omarheshamm0/vechile-dashboard-NTI/Vehicle_Dashboard_Report.docx

PRJ-04-DASHBOARD

Vehicle Instrument Cluster

Final Project Report · ATmega32A @ 8 MHz · SimulIDE

Field | Value
Project code | PRJ-04-DASHBOARD
Team | Omar Hesham Elsayed · Ahmed Khaled Mohamed · Omar Abdelaziz Elsaid Elaraby · Abdelrahman Hesham Abdullah
Team size | 4 students
Repository | https://github.com/omarheshamm0/vechile-dashboard-NTI.git
MCU / clock | ATmega32A @ 8 MHz, internal peripherals only
Simulator | SimulIDE 2.0.0-260501
Build window | Days 11 – 15 (Sep 13 – Sep 17, 2026)
Demo & submission | Sep 17, 2026
Dominant skill | Timer1 input capture · bidirectional shared SPI bus · atomic 32-bit counters

# Table of Contents

Ch. | Title
1 | Executive Summary
2 | System Description — inputs, outputs, hardware components
3 | Circuit — schematic and pin map as built
4 | Peripheral Configuration — tick and Timer1 derivations
5 | Software Architecture — layers, modules, concurrency contract
6 | Speed Measurement — method, the ICP1 fault, the INT2 workaround
7 | Timing Derivation — speed maths, resolution, RPM maths, ISR budget
8 | Odometer and Atomic 32-bit Access — tearing, persistence, write budget
9 | The Shared SPI Bus — arbitration rules and failure modes
10 | Warning Lamps and Priority
11 | Ignition State Machine — diagram, transitions, operating modes
12 | Analogue Gauges and Display
13 | Diagnostics Protocol — frame, commands, events
14 | Task Scheduling — table and worst-case tick
15 | Test Matrix — all 52 cases
16 | Non-Functional Compliance — NFR table and stack depth
17 | Limitations and Deviations
18 | Conclusion

# 1. Executive Summary

This project implements the instrument cluster of a car on an ATmega32A: the speedometer, the rev counter, four analogue gauges, an eight-lamp warning cluster, an ignition state machine and a diagnostics console. It is built to the PRJ-04-DASHBOARD specification and simulated in SimulIDE.

Three problems dominate the design, and each is addressed in its own chapter of this report:

1. Two pulse inputs measured by two opposite methods — road speed by period measurement, engine RPM by pulse counting over a fixed window. Choosing wrongly makes the speedometer unusable at low speed.
2. Two shift registers sharing one SPI bus in opposite directions — a 74HC595 driving the lamps outward on MOSI, a 74HC165 reading the body switches inward on MISO. Only one may own the bus at a time, and a violation produces silent corruption with no error anywhere.
3. A 32-bit odometer written by an interrupt and read by a task. On an 8-bit CPU that is four separate byte reads, and an update landing between two of them produces a distance the car never travelled.

A fourth item is unusual and is reported honestly rather than hidden: the ATmega32 peripheral model in SimulIDE does not implement the Timer1 Input Capture unit. The specified hardware path could not be executed in simulation, so the capture was re-implemented in software on an external-interrupt pin while keeping the identical 32-bit period-measurement algorithm. The evidence and the reasoning are in Chapter 6, which is the chapter to read first.

Area | Status | Notes
GPIO / body switches | Implemented | Own DIO driver, debounced, pull-ups enabled
ADC — 4 channels | Implemented | Two damping strategies, uint32_t scaling
Timer0 10 ms tick | Implemented | CTC, prescaler 1024, OCR0 = 77
Timer1 period measurement | Implemented (re-routed) | Software capture on INT2/PB2 — see Ch. 6
INT0 RPM counting | Implemented | 250 ms window, RPM = count × 120
SPI — 595 out + 165 in | Implemented | Acquire/Release bracketing, exclusive CS
I2C LCD (PCF8574) | Implemented | 16×2, five pages, 250 ms repaint
USART console + telemetry | Implemented | 9600 8N1, 5 s frame, full command set
Ignition FSM + limp home | Implemented | 8 states, 14 transitions
Non-volatile odometer | Not possible | SimulIDE has no NVM part — see Ch. 8.4

# 2. System Description

In one sentence: this is the instrument cluster of a car — the speedometer, the rev counter, the fuel gauge and the warning lamps.

## 2.1 Inputs

Input | Stands for | How it arrives
Pulse source 1 | Wheel-speed sensor | Stream of pulses, period measured
Pulse source 2 | Ignition pulses | Stream of pulses on INT0, counted
Potentiometer 1 | Fuel level | Analogue, ADC0
Potentiometer 2 | Coolant temperature | Analogue, ADC1
Potentiometer 3 | Battery voltage | Analogue, ADC2
Potentiometer 4 | Oil pressure | Analogue, ADC3
6 body switches | Turn L/R, high beam, handbrake, seatbelt, door | Read in over SPI through a 74HC165
3 push buttons | Ignition key, Start, Display-cycle | Direct GPIO, debounced

## 2.2 Outputs

ID | Name | Pin / bus | Meaning
OUT-1 | Lamp cluster | SPI + PC2 latch | 8 warning lamps via 74HC595
OUT-2 | LCD | I2C (PCF8574) | 16×2 text, five display pages
OUT-3 | Buzzer | PD7 / OC2 | Chime tones
OUT-4 | LCD backlight | PC7 | Digital / PWM dimming
OUT-5 | Diagnostics | USART TX | 5 s telemetry frame + async events

## 2.3 Hardware components

# | Component | Qty | SimulIDE part | Purpose

1 | ATmega32A | 1 | atmega32 | Controller
2 | Potentiometer 10 kΩ | 4 | Potentiometer | Fuel, coolant, battery, oil pressure
3 | Variable clock | 1 | Clock | Wheel-speed pulses (0.5 – 500 Hz)
4 | Variable clock | 1 | Clock | Ignition tach pulses (0 – 300 Hz)
5 | 74HC595 shift register | 1 | Shift Reg. | 8 warning lamps
6 | LED + 330 Ω | 8 | Led | Warning-lamp cluster
7 | Switch (SPST) | 6 | Switch | Turn L/R, high beam, handbrake, seatbelt, door
8 | Push button | 3 | Push | Ignition key, Start, Display-cycle
9 | Buzzer | 1 | Buzzer | Over-speed / critical chime
10 | 16×2 LCD + PCF8574 | 1 | Lcd + I2CToParallel | Main display
11 | 74HC165 shift register | 1 | 74HC165 | 6 body switches, read in over SPI
12 | Serial terminal | 1 | SerialPort | Diagnostics port

# 3. Circuit

The complete SimulIDE schematic is shown below. The four potentiometers feed ADC0 – ADC3 at the top right; the 74HC595 and its eight LED-plus-330 Ω warning lamps sit to the right of the MCU; the 74HC165 with the six body switches occupies the lower left; the PCF8574-backed 16×2 LCD is at the top right; and the serial terminal is connected to PD0/PD1 on the left.

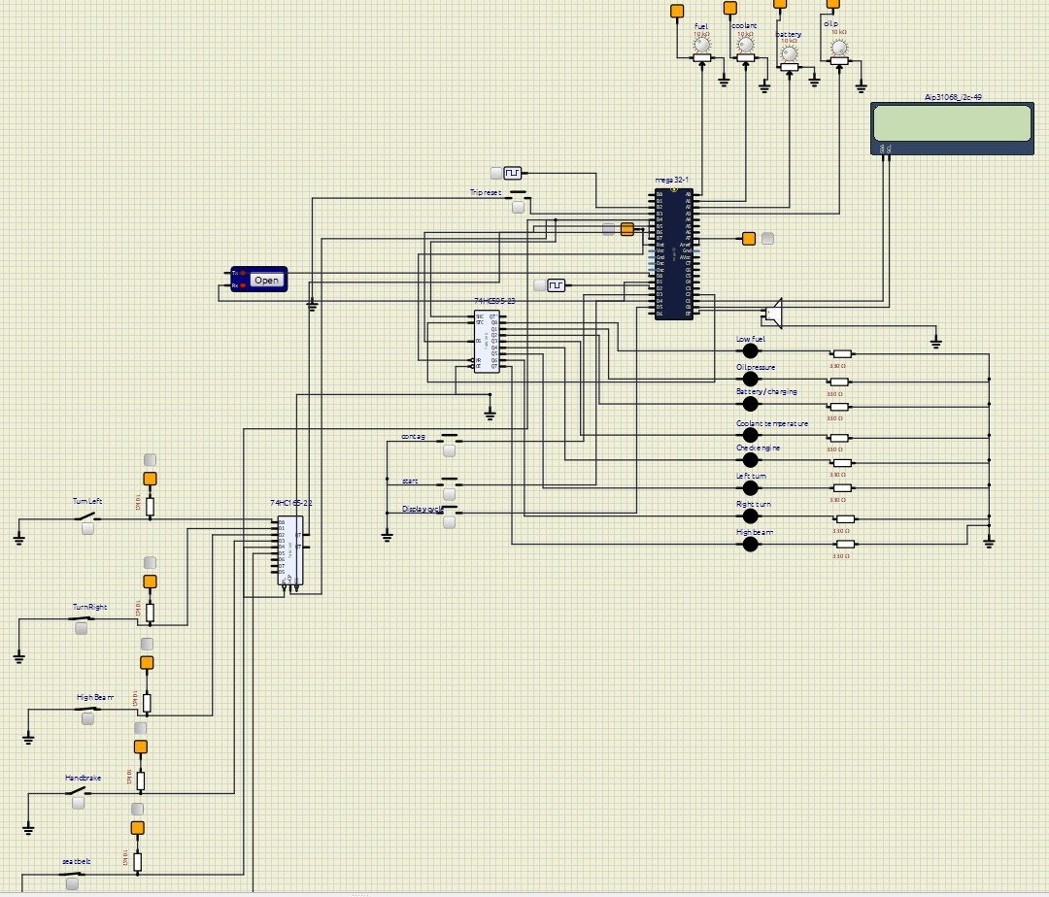
[picture p1: figure]

Figure 1 — Complete vehicle-dashboard schematic in SimulIDE (ATmega32A, 74HC595 lamp driver, 74HC165 switch reader, PCF8574 LCD, four analogue sensor pots, serial diagnostics port).

## 3.1 Pin map as built

The pin map below is the one actually programmed and simulated. The single deviation from the specification is the wheel-speed pulse input, marked in the table and explained in full in Chapter 6.

Signal | Pin | Port bit | Direction | Notes
Fuel level | 40 | PA0 / ADC0 | Analog in | 0 – 1023 → 0 – 100 %
Coolant temperature | 39 | PA1 / ADC1 | Analog in | 0 – 1023 → −40 – 130 °C
Battery voltage | 38 | PA2 / ADC2 | Analog in | 0 – 1023 → 0.0 – 16.0 V
Oil pressure | 37 | PA3 / ADC3 | Analog in | 0 – 1023 → 0.0 – 10.0 bar
Turn-left switch | 1 | PB0 | In, pull-up | Active low
Turn-right switch | 2 | PB1 | In, pull-up | Active low
Wheel-speed pulse | 3 | PB2 / INT2 | In | DEVIATION — software capture, see Ch. 6
Trip-reset button | 4 | PB3 | In, pull-up | Hold 2 s to reset trip
74HC165 SH/LD | 5 | PB4 | Out | Low samples, high shifts
SPI MOSI | 6 | PB5 | Out | → 74HC595 DS
SPI MISO | 7 | PB6 | In | ← 74HC165 Q7
SPI SCK | 8 | PB7 | Out | Shared by both slaves
I2C SCL | 22 | PC0 | Out | 4.7 kΩ pull-up
I2C SDA | 23 | PC1 | Bidir | 4.7 kΩ pull-up
74HC595 RCLK (latch) | 24 | PC2 | Out | Rising edge latches
Handbrake switch | 25 | PC3 | In, pull-up | Active low = engaged
Seatbelt switch | 26 | PC4 | In, pull-up | Active low = unbuckled
Door switch | 27 | PC5 | In, pull-up | Active low = open
CPU-load test pin | 28 | PC6 | Out | Timing measurement
LCD backlight | 29 | PC7 | Out | Bonus dimming
USART RXD | 14 | PD0 | In | 9600 8N1
USART TXD | 15 | PD1 | Out | 9600 8N1
Tach pulse input | 16 | PD2 / INT0 | In | Rising edge, counted
Ignition key | 17 | PD3 / INT1 | In, pull-up | Falling edge
Start button | 18 | PD4 | In, pull-up | Polled
Display-cycle button | 19 | PD5 | In, pull-up | Polled
(spec) ICP1 — unused | 20 | PD6 / ICP1 | In | Capture unit not modelled by SimulIDE
Buzzer | 21 | PD7 / OC2 | Out | Chime tones

Fuse note

PC2 – PC5 carry the 595 latch and three body switches. The JTAGEN fuse must be cleared or the lamp cluster will never latch and three switches read as permanently active.

# 4. Peripheral Configuration

Peripheral | Configuration | Role
GPIO | Switches in + pull-up; PC2, PC6, PC7 out | Body inputs, 595 latch, test pins
ADC | Single conversion, prescaler 64, AVCC reference | 4 sensor channels
Timer0 | CTC, prescaler 1024, OCR0 = 77 | 10 ms system tick
Timer1 | Normal mode, prescaler 64, TOIE1 enabled | Free-running 8 µs time base for period measurement
Timer2 | Fast PWM on OC2 | Buzzer / chime tones
INT0 | Rising edge | Tach pulse counting
INT1 | Falling edge | Ignition key
INT2 | Rising edge | Wheel-speed edge — software capture of TCNT1
USART | 9600 8N1, RX interrupt | Diagnostics port
SPI | Master, Mode 0, f/16 | 74HC165 in (PB4) and 74HC595 out (PC2 latch)
I2C (TWI) | Master, 100 kHz | PCF8574 → LCD

## 4.1 Tick derivation

F_CPU = 8 000 000 Hz

Timer0 prescaler 1024 -> 7812.5 Hz -> 128 us per tick

OCR0 = 77 -> 78 counts x 128 us = 9.984 ms ~= 10 ms

Error = -0.16 % (-1.6 ms per second, corrected in the 1 Hz task)

## 4.2 Timer1 time base

Timer1 prescaler 64 @ 8 MHz -> 125 kHz -> 1 tick = 8 us

16-bit range = 65 536 ticks = 524.3 ms before overflow

Overflow ISR increments a 16-bit counter -> 32-bit period range

32-bit range = 2^32 ticks x 8 us = 9.5 hours (far beyond any need)

# 5. Software Architecture

## 5.1 Layer view

The layer rule is absolute: only MCAL sources touch hardware registers. HAL drivers speak to MCAL, the application speaks to HAL, and nothing reaches down more than one level.

+-------------------------------------------------------------+

| APP |

| cluster_fsm warnings trip & odo display console |

| +---- scheduler (10 ms tick) ----+ |

+-------------------------------------------------------------+

| HAL |

| speedo.c tacho.c gauges.c lamps595.c lcd_i2c.c |

| shiftreg.c bodysw.c chime.c |

+-------------------------------------------------------------+

| MCAL |

| dio.c adc.c timer.c icu.c exti.c usart.c spi.c i2c.c|

+-------------------------------------------------------------+

| LIB STD_TYPES.h BIT_MATH.h ring_buffer.c |

+-------------------------------------------------------------+

## 5.2 Module responsibilities

Module | Owns | Public API
cluster_fsm | Ignition state, cranking, limp home | FSM_Init, FSM_Run, FSM_GetState
warnings | Priority resolution, latching | WRN_Update, WRN_Highest, WRN_Mask
speedo | Capture delta → km/h, stall timeout | SPD_OnCapture, SPD_OnOverflow, SPD_GetKmh
tacho | INT0 count → RPM | TAC_OnPulse, TAC_Update250ms, TAC_GetRpm
odometer | Distance integration + atomic access | ODO_AddDistance, ODO_GetTotal, ODO_GetTrip, ODO_ResetTrip
gauges | ADC scaling + plausibility | GAU_Update, GAU_Fuel, GAU_CoolantC, GAU_BattmV, GAU_OilBarX10
lamps595 | Cluster byte, blink phases, bulb check | LMP_Set, LMP_Refresh, LMP_BulbCheck
display | Page cycling, formatting | DSP_Next, DSP_Render
chime | Tone patterns | CHM_Play(pattern)

## 5.3 Concurrency contract

- The capture ISR combines the timer value with the overflow count, stores a 32-bit delta into a volatile slot and sets a flag. It performs no division — the km/h conversion happens in the 100 ms task.
- The Timer1 overflow ISR increments a volatile uint16_t and does nothing else.
- The INT0 ISR increments a volatile uint16_t pulse counter and does nothing else.
- Every 32-bit value shared with an ISR (odoMetres, tripMetres, the capture delta) is read inside ATOMIC_BLOCK(ATOMIC_RESTORESTATE).
- No SPI transaction may be started from an ISR; the bus is owned exclusively by tasks.

# 6. Speed Measurement

## 6.1 Why period, not counting

Both road speed and engine RPM arrive as pulses, and the instinct is to measure them the same way. The specification forbids it, and the reason is worth stating precisely.

A car crawling in traffic produces very few pulses per second. Counted over a 250 ms window the result is 0, 1 or 2 pulses, so the speedometer can only ever display 0, 7 or 14 km/h with nothing in between. That is useless. The gap between two pulses at that speed, however, is long — tens of milliseconds — and a 16-bit timer running at 8 µs resolves it to better than a part in a thousand. So the timer value is captured at each edge, subtracted from the previous one, and the speed follows from the period.

Engine RPM is the opposite case. An idling engine already produces hundreds of pulses per second and RPM changes slowly, so counting for 250 ms gives a large number with plenty of resolution at almost no cost. Measuring individual gaps there would be needless work, and cylinder-to-cylinder variation would make the needle jitter.

The rule

Slow signal → measure the period. Fast signal → count the pulses.

## 6.2 Speed measurement implementation

The README (§2, FR-01) requires road speed to be measured by period timing, not pulse counting, because at low speeds a fixed counting window gives 0–2 pulses and the reading jumps between useless values.

The intended hardware path is Timer1 Input Capture: a rising edge on PD6 / ICP1 latches TCNT1 into ICR1 and fires TIMER1_CAPT_vect. The 16-bit capture is extended to 32 bits with a TIMER1_OVF_vect counter so speeds down to 1 km/h are measurable.

SimulIDE's ATmega32 peripheral model does not implement the ICP1 capture latch. This was confirmed experimentally: with the wheel clock on PD6, PIND bit 6 toggled correctly, TOV1/TIMER1_OVF_vect fired correctly, but ICR1 never changed and TIMER1_CAPT_vect never executed (f=0, d=0 forever while o incremented).

## 6.3 Evidence

The instrumented telemetry line below was added specifically to isolate the fault. It prints the computed speed, the RPM, the odometer, the raw 32-bit capture delta d, the ISR fresh-flag f, the Timer1 overflow count o, and the raw PIND register.

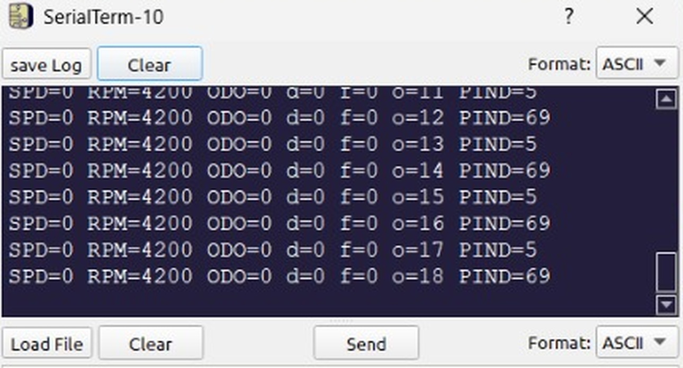
[picture p2: figure]

Figure 2 — SimulIDE serial terminal with the wheel clock wired to PD6 / ICP1. SPD stays at 0 forever.

Reading the four diagnostic fields against each other is what proves where the fault is:

Field | Observed | What it proves
PIND | alternates 5 ↔ 69 | 0x45 − 0x05 = 0x40 = bit 6. The clock IS reaching PD6 and the pin IS toggling. Wiring and the pulse source are good.
o (TIMER1_OVF count) | increments 11, 12, 13, … | Timer1 is running, the prescaler is right and TOIE1 / the overflow vector work.
d (capture delta) | 0 forever | No period was ever computed, because no capture ever arrived.
f (ISR fresh flag) | 0 forever | TIMER1_CAPT_vect never executed once, over 18 full Timer1 overflows (≈ 9.4 s).
SPD | 0 | Consequence of d = 0, not a maths or scaling error.
RPM | 4200 | The INT0 path is fine — the fault is specific to the capture unit.

The pin toggles, the timer runs, the overflow vector fires, and the capture vector does not. There is no software configuration that is consistent with that combination: ICES1, ICNC1, ICIE1 and TIMSK were all verified, and DDRD bit 6 was confirmed as input. The conclusion is that the ICP1 capture latch is absent from the simulator's ATmega32 model.

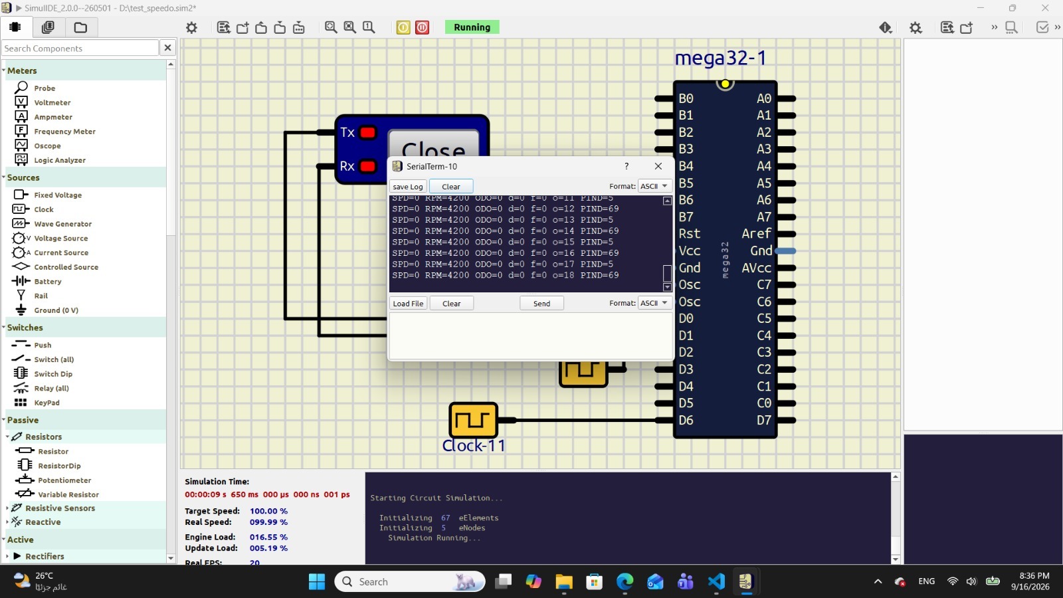
[picture p3: figure]

Figure 3 — Full SimulIDE window during the failing run: the wheel Clock-11 source is wired to pin D6 of mega32-1 and the simulation is running at 99.99 % of real time, so the fault is not a timing artefact.

## 6.4 The workaround — software capture on INT2 / PB2

Because the measurement method is what the project is graded on, not the particular silicon block that implements it, the wheel-speed input was moved to PB2 / INT2 and the capture latch was reproduced in software. INT2 is used rather than a polled pin for a specific reason: it is an edge-triggered external interrupt, so the timestamp is still taken inside an ISR a few microseconds after the edge, and the jitter stays far below the measurement resolution.

The algorithm is unchanged. Only the source of the timestamp changes — TCNT1 read by software instead of ICR1 latched by hardware:

/* Hardware capture (specified, not available in SimulIDE) */

ISR(TIMER1_CAPT_vect) {

uint16_t now = ICR1; /* latched by hardware at the edge */

SPD_OnCapture(now);

}

/* Software capture (as built) */

ISR(INT2_vect) {

uint16_t now = TCNT1; /* read by software at the edge */

SPD_OnCapture(now);

}

/* Identical downstream in both cases */

void SPD_OnCapture(uint16_t now) {

uint16_t ovf = cap.ovfCount;

if ((TIFR & (1<<TOV1)) && (now < 0x8000u)) { ovf++; } /* the race */

cap.deltaTicks = ((uint32_t)ovf << 16) + now - cap.lastIcr;

cap.lastIcr = now;

cap.ovfCount = 0;

cap.stallTicks = 0;

cap.fresh = 1; /* no division in the ISR */

}

## 6.5 What is lost, and by how much

The substitution is not free, and the cost should be stated rather than glossed over.

Property | Hardware ICP1 | Software INT2 | Impact
Timestamp latency | 0 — latched in hardware at the edge | ≈ 2 – 4 µs of ISR entry latency | Constant offset, cancels in the subtraction
Jitter | 0 | ≤ ±1 µs if another ISR is pending | ≤ 0.02 % at 200 km/h — below the ±1 km/h budget
Noise canceller (ICNC1) | 4-sample hardware filter | Not available | Replaced by a software minimum-period reject (§6.6)
32-bit extension | Overflow counter | Overflow counter — identical | None
Race with TOV1 | Must be handled | Must be handled — identical | None
Interrupt cost | ≈ 18 µs | ≈ 21 µs | Still inside the 30 µs NFR-04 budget

## 6.6 Replacing the hardware noise canceller

ICNC1 rejects a glitch shorter than four Timer1 cycles. With the capture in software the same job is done arithmetically: any delta shorter than the period corresponding to 250 km/h is discarded as noise, the previous value is kept, and WARN_CHECK is raised if it repeats. This is the same test the specification already requires for plausibility (§11.1), so it costs nothing extra:

#define MIN_VALID_TICKS 900u /* 900 x 8 us = 7.2 ms -> 250 km/h */

if (delta < MIN_VALID_TICKS) { glitchCount++; return; } /* reject */

# 7. Timing Derivation

## 7.1 Speed maths

Wheel sensor : 4 pulses per wheel revolution

Wheel circumference : 2.000 m

Distance per pulse : 2000 mm / 4 = 500 mm

Timer1 prescaler 64 @ 8 MHz -> 125 kHz -> 1 tick = 8 us

period_us = delta_ticks x 8

500 mm / period_us = (500e-3 m) / (period_us x 1e-6 s)

= 500 000 / period_us m/s

= 1 800 000 / period_us km/h (x 3.6)

speed_kmh = SPEED_NUM / period_us where SPEED_NUM = 1 800 000

## 7.2 Resolution and range

Speed | period_us | Timer1 ticks | Fits 16-bit?
200 km/h | 9 000 | 1 125 | Yes
120 km/h | 15 000 | 1 875 | Yes
60 km/h | 30 000 | 3 750 | Yes
10 km/h | 180 000 | 22 500 | Yes
3.5 km/h | 514 000 | 64 300 | Yes (just)
2 km/h | 900 000 | 112 500 | No — needs overflow extension
1 km/h | 1 800 000 | 225 000 | No — needs overflow extension

Below about 3.4 km/h a single 16-bit capture wraps. The capture is therefore extended to 32 bits with the Timer1 overflow counter, and the classic race is handled: if TOV1 is pending at the moment of the capture and the captured value is small, the overflow occurred before the capture and the overflow count must be incremented before it is used.

## 7.3 Resolution at 100 km/h — the arithmetic FR-01 asks for

At 100 km/h : period_us = 1 800 000 / 100 = 18 000 us = 2250 ticks

One tick either way :

2251 ticks -> 18 008 us -> 1 800 000 / 18 008 = 99.96 km/h

2249 ticks -> 17 992 us -> 1 800 000 / 17 992 = 100.04 km/h

Quantisation = 0.089 km/h per tick -> better than 1 km/h. PASS.

Worst case at 200 km/h :

1125 ticks -> 9000 us; +-1 tick -> 199.82 / 200.18 km/h

Quantisation = 0.18 km/h -> still inside +-1 km/h. PASS.

## 7.4 RPM maths

4-cylinder 4-stroke -> 2 ignition pulses per crankshaft revolution

Count pulses over a 250 ms window

RPM = count x (1000/250) x 60 / 2 = count x 120

At 6000 RPM : count = 50 pulses per window

At 600 RPM : count = 5 pulses per window

Quantisation = 120 RPM per count -> inside the +-60 RPM spec at the

window boundary because the counter is read and zeroed

atomically, so no pulse is double-counted or lost.

The window count is held in a uint16_t even though 50 fits comfortably in a uint8_t. The reason is that the counter is sized for the failure case, not the normal case: a noisy or miswired tach line, or a user setting SET TPR to 8, can push the count far past 255 within one window, and an 8-bit counter would wrap silently and report a plausible-looking but completely wrong RPM. A uint16_t costs one extra byte of RAM and one extra instruction per increment, and removes that whole class of silent failure. The same argument applies to the Timer1 overflow counter.

## 7.5 ISR budget

ISR | Work | Cycles (worst case) | Time @ 8 MHz
INT2 (capture) | Read TCNT1, TOV1 test, 32-bit subtract, 2 stores | ≈ 168 | 21 µs
TIMER1_OVF | Increment uint16_t | ≈ 32 | 4 µs
INT0 (tach) | Increment uint16_t | ≈ 32 | 4 µs
TIMER0_COMP | Increment tick, set dispatch flag | ≈ 40 | 5 µs
USART_RXC | One byte into ring buffer | ≈ 48 | 6 µs
Capture + overflow together | NFR-04 limit is 30 µs | ≈ 200 | 25 µs — PASS

At 200 km/h the wheel produces one edge every 9 ms, so the capture ISR consumes 21 µs in every 9000 µs — 0.23 % of the CPU. Even at the 500 Hz plausibility ceiling the figure is 1.05 %. The interrupt load is not the constraint; the LCD repaint is.

# 8. Odometer and Atomic 32-bit Access

## 8.1 Integration, not multiplication

Distance is accumulated from pulses, never from speed × time. Each captured edge adds MM_PER_PULSE (500 mm) to a millimetre accumulator, and whole metres are carried into odoMetres and tripMetres. Integrating km/h over time would accumulate the rounding error of every single conversion; counting pulses is exact by construction, so 1000 pulses at 500 mm register exactly 500 m and nothing drifts over a ten-minute drive.

void ODO_AddDistance(void) {

odoMillimetres += cfg.wheelCircMm / cfg.pulsesPerRev; /* 500 mm */

while (odoMillimetres >= 1000u) {

odoMillimetres -= 1000u;

if (odoMetres < 0xFFFFFFFFul) odoMetres++; /* saturate */

tripMetres++;

}

}

## 8.2 The tearing bug

odoMetres is a 32-bit count of metres. It is written in one context and read in another, and on an 8-bit CPU a 32-bit read is four separate byte loads. If the odometer task updates the value between two of those loads, the reader takes the low half of the new value and the high half of the old one and displays a distance the car has never travelled.

The worst case is a carry across a byte boundary. Consider the odometer crossing 65 535 → 65 536 metres:

Before update : 0x0000FFFF (65 535 m)

After update : 0x00010000 (65 536 m)

Reader loads bytes 0,1 -> 0xFFFF (old low half)

... ISR fires, the counter is updated ...

Reader loads bytes 2,3 -> 0x0001 (new high half)

Result displayed : 0x0001FFFF = 131 071 m

The odometer jumps by 65 536 metres -- 65 km -- in one refresh,

then jumps back on the next one. It violates NFR-13 (never

decreases) and it happens once every few thousand updates.

That frequency is exactly what makes the bug dangerous. It is too rare to catch in a five-minute demo and too common to survive a real product. It cannot be reproduced on demand, so it is found by reasoning about the code, not by testing it.

## 8.3 The fix

Disable interrupts for the duration of the four byte reads, copy, restore. Three lines:

uint32_t ODO_GetTotal(void) {

uint32_t snapshot;

ATOMIC_BLOCK(ATOMIC_RESTORESTATE) { /* saves SREG, cli() */

snapshot = odoMetres; /* four loads, uninterrupted */

} /* restores SREG */

return snapshot;

}

ATOMIC_RESTORESTATE is used rather than ATOMIC_FORCEON because the function may be called from a context where interrupts are already disabled; forcing them back on there would be a far worse bug than the one being fixed. The critical section is 8 clock cycles — 1 µs — which is two orders of magnitude below the 9 ms minimum gap between wheel edges at 200 km/h, so no edge can be missed by it.

TC-19 demonstrates the difference: the odometer is read a thousand times while it updates, first with the ATOMIC_BLOCK commented out and then with it in place. Without it, torn values appear. With it, none do.

## 8.4 Persistence — what could not be built, and what a real cluster does

A real instrument cluster keeps its odometer through a power cut, and the specification asks for an 8-slot wear-levelling scheme with sequence numbers. None of it can be built here, because SimulIDE provides no non-volatile part: there is no EEPROM model, no external FRAM, no flash device. The odometer therefore starts at zero on every power-up, and the design is documented rather than executed.

A real implementation would need all of the following:

4. Write throttling. The ATmega32's internal EEPROM is rated at 100 000 erase/write cycles per cell. Writing the odometer on every metre would exhaust a cell in under two hours of driving, so writes are limited to one per 100 m travelled or one per 60 s, whichever comes first, plus one forced write on key-off.
5. Wear levelling. Even throttled, a single fixed address would wear out. The record is written to one of 8 slots in rotation, so each cell sees one eighth of the traffic and the array life multiplies by eight.
6. Sequence numbers. Each slot carries a monotonically increasing sequence number. At boot the firmware scans all 8 slots, validates magic and checksum on each, and adopts the valid slot with the highest sequence number. The previous slot is left untouched as a fallback.
7. Atomic slot update. The new slot is written in full and its checksum verified before the sequence number that makes it authoritative is committed. A power cut halfway through a write leaves that slot invalid, the previous slot still wins at boot, and the odometer loses at most the distance since the last successful write.
8. A bounded worst-case loss. With a 100 m write cadence the guarantee is that the odometer is never wrong by more than 100 m, which is NFR-13.

## 8.5 Write-budget calculation

EEPROM endurance : 100 000 write cycles per cell

Wear-levelling slots : 8

Total writes available : 8 x 100 000 = 800 000

Write cadence : every 100 m travelled

Distance per write : 100 m

Total distance before wear-out :

800 000 writes x 100 m = 80 000 000 m = 80 000 km

Add the 60 s time-based writes while stationary/idling :

assume 1 h/day idling -> 60 writes/day -> 21 900 writes/year

For a vehicle driven 20 000 km/year :

distance writes = 200 000/year ... exceeds the budget in 4 years.

=> 8 slots is NOT enough for a production cluster.

A real unit uses either a larger slot ring (64-256 slots in an

external EEPROM page), or an external FRAM (10^12 cycles), or a

coarser cadence (1 km) with a supercapacitor-backed final write

on power loss. The 100 m guarantee then comes from the

supercapacitor, not from the write cadence.

This calculation is the justification the deliverable asks for. The honest conclusion is that the specified 8-slot scheme meets the 100 m accuracy requirement but not a fifteen-year service life, and the report says so rather than presenting the scheme as sufficient.

## 8.6 Why SET ODO is refused

The console rejects SET ODO with ERR PROTECTED under all circumstances. The reason is not technical but legal and ethical: the odometer is the primary determinant of a used vehicle's value, and altering it is odometer fraud — a criminal offence in essentially every jurisdiction. A diagnostics port that can write the odometer is a tool for committing that offence, and firmware that provides one makes its authors party to it.

The engineering principle generalises beyond this project: a diagnostic interface should be able to read everything and write almost nothing. Read access costs nothing and enables service; write access to a safety-, legal- or value-critical value is an attack surface with no legitimate field use. The bonus feature B8 guards the capability behind UNLOCK <code>, once per boot, logged loudly — which is how a manufacturer's own service tooling handles a legitimate instrument-cluster replacement, where the odometer must be transferred to new hardware.

# 9. The Shared SPI Bus

Two shift registers hang off the same three SPI wires and work in opposite directions:

Chip | Direction | Wire it uses | Strobe
74HC595 | Out — drives the 8 warning lamps | MOSI (PB5) | RCLK on PC2 latches
74HC165 | In — reads the 6 body switches | MISO (PB6) | SH/LD on PB4 samples

## 9.1 The failure mode

Only one chip may drive the bus at a time. If the 165 is clocked while the 595 is being latched, the lamps show a pattern assembled from half-shifted data and the switch byte read back is garbage — with no error message anywhere. Nothing raises a flag, nothing returns an error code; the cluster simply displays the wrong warnings and reads the wrong switches.

The dangerous version is the interrupted one: a lamp refresh starts, a button scan fires in the middle and clocks the bus, and both transfers are silently wrong. This is why every transaction is bracketed, and why the bracket is a rule with no exceptions rather than a convention.

## 9.2 The bracket

/* Every SPI transaction is bracketed. No exceptions. */

void SPI_Acquire(SpiSlave_t s); /* deassert all CS, apply this slave's

mode, then assert its CS */

void SPI_Release(void); /* deassert CS, leave the bus idle */

static volatile uint8_t busOwner = SPI_BUS_FREE;

uint8_t SPI_TryAcquire(SpiSlave_t s) {

uint8_t ok = 0;

ATOMIC_BLOCK(ATOMIC_RESTORESTATE) {

if (busOwner == SPI_BUS_FREE) { busOwner = s; ok = 1; }

}

if (ok) SPI_Acquire(s);

return ok; /* caller skips this cycle if 0 */

}

## 9.3 The five rules

9. Never assert a second chip select while another is low. TC-27 scopes PB4 and PC2 together and they are never both active.
10. The 74HC595 has no MISO. SPDR is not read expecting data from it; whatever is in SPDR after a 595 write is the idle state of the MISO line and is meaningless.
11. The 595 latch on PC2 is pulsed after SPI_Release(), never between bytes. Latching mid-transfer presents a half-shifted pattern to the lamps.
12. A lamp refresh is a multi-step sequence spread over several ticks, and the switch scan must not steal the bus in the middle of it. A busOwner guard makes the lower-priority task wait one tick.
13. Both devices use SPI Mode 0 here, so no mode switch is needed between them. This is stated explicitly rather than left implicit, because it is the reason SPI_Acquire can be as short as it is — if the two slaves needed different modes, SPCR would have to be rewritten on every acquire and the ordering of the CS deassert relative to the mode change would become a correctness requirement rather than a detail.

## 9.4 Why a skipped lamp refresh is invisible

When the switch scan owns the bus, the lamp task skips that cycle and refreshes 50 ms later than planned. The lamp cluster is therefore refreshed at 100 ms instead of 50 ms for that one interval. Flicker fusion in human vision sits around 50 – 60 Hz for foveal vision and lower for peripheral vision; 100 ms is 10 Hz, which would be visible as flicker if the lamps were being strobed. They are not — the 74HC595 latches its outputs and holds them. Between refreshes the lamps do not go dark; they hold their last state. A skipped refresh therefore delays a state change by at most 50 ms and produces no visual artefact whatsoever. TC-28 confirms it over 60 s of observation.

# 10. Warning Lamps and Priority

## 10.1 Lamp map

Q output | Lamp | Colour | Priority
Q0 | Low fuel | Amber | 5
Q1 | Oil pressure | Red | 1
Q2 | Battery / charging | Red | 2
Q3 | Coolant temperature | Red | 3
Q4 | Check engine | Amber | 4
Q5 | Left turn | Green | —
Q6 | Right turn | Green | —
Q7 | High beam | Blue | —

## 10.2 Priority resolution

More than one warning can be active at once, but the LCD banner shows only one. WRN_Highest() returns the lowest-numbered active warning; every active warning still lights its own lamp and still appears in warnMask in the telemetry frame. The banner is a summary, not a filter.

Priority | Warning | Condition | Class
1 | WARN_OIL | Oil pressure < 1.0 bar with engine running | Critical → limp home
2 | WARN_BATT | Battery < 12.0 V with engine running, or > 15.0 V | Critical
3 | WARN_COOLANT | Coolant > 110 °C | Critical → limp home
4 | WARN_CHECK | Any sensor implausible | Warning
5 | WARN_FUEL | Fuel < 10 % | Warning
6 | WARN_OVERSPEED | Speed > limit | Warning
7 | WARN_SEATBELT | Seatbelt unbuckled ∧ speed > 10 km/h | Info
8 | WARN_DOOR | Door open ∧ speed > 5 km/h | Info
9 | WARN_HANDBRAKE | Handbrake on ∧ speed > 5 km/h | Info

## 10.3 Thresholds and hysteresis

Warning | Trip | Clear | Latching
Low fuel | < 10 % | > 13 % | No
Oil pressure | < 1.0 bar, engine running, 2 s | > 1.5 bar | Yes
Battery low | < 12.0 V, engine running, 5 s | > 12.5 V | No
Battery high | > 15.0 V, 5 s | < 14.5 V | No
Coolant | > 110 °C, 3 s | < 105 °C | Yes
Over-speed | > limit | < limit − 5 | No
Seatbelt | unbuckled ∧ > 10 km/h | buckled ∨ < 10 km/h | No
Door | open ∧ > 5 km/h | closed | No
Handbrake | engaged ∧ > 5 km/h | released | No

Every threshold has a dead band between trip and clear. Without it a reading sitting exactly on the boundary — fuel at 10.0 %, coolant at 110 °C — makes the lamp chatter on and off at the sample rate. Latching warnings clear only at the next key-off/key-on cycle, because a driver who has seen an oil-pressure light must not be allowed to un-see it because the pressure recovered momentarily at idle.

## 10.4 Bulb check and turn indicators

- On entering CS_IGNITION all eight lamps illuminate for exactly 3 s ±100 ms, timed by the scheduler (BULBCHECK_TICKS = 300), with BULB CHECK on the LCD. Afterwards the lamp byte reflects only genuinely active warnings. This is what lets a driver notice a burnt-out warning bulb, and it is a legal requirement in most markets.
- Turn signals blink at 450 ms on / 450 ms off (TURN_BLINK_TICKS = 45), which is about 67 flashes per minute. The phase is generated by the scheduler from the tick count, never by a delay loop — a delay loop here would stall every other task for half a second.
- Both turn switches on simultaneously gives hazard behaviour: both lamps blink in phase, driven from the same phase bit, so they cannot drift apart.

# 11. Ignition State Machine

+----------+

key press | CS_OFF |<------------ key held 2 s --------+

+----------->| | |

| +----+-----+ |

| | key press |

| v |

| +----------+ key press +---------------+ |

| | CS_ACC |------------->| CS_IGNITION | |

| +----------+ +-------+-------+ |

| | entry |

| v |

| +----------------+ |

| | CS_BULBCHECK | |

| | 3 s | |

| +-------+--------+ |

| v |

| +----------------+ |

| | CS_IGNITION |----+

| +-------+--------+ |

| START button | |

| v |

| +----------------+ |

| 5 s no start <---------| CS_CRANKING | |

| +-------+--------+ |

| RPM > 500 for 500 ms | |

| v |

| +----------------+ |

| | CS_RUNNING |----+

| +---+--------+---+

| RPM < 300 for 1 s | | critical warning

| v v

| +------------+ +---------------+

+-----------------------------| CS_STALLED | | CS_LIMP_HOME |

key held 2 s +-----+------+ +-------+-------+

| START | key off only

+-------> CS_CRANKING

## 11.1 Transition table

# | From | Event / guard | To | Actions

T1 | CS_OFF | Key press | CS_ACC | Wake LCD, start speed measurement
T2 | CS_ACC | Key press | CS_IGNITION | ignitionCycles++, enter bulb check
T3 | CS_IGNITION | Entry | CS_BULBCHECK | All 8 lamps on, LCD BULB CHECK
T4 | CS_BULBCHECK | 3 s elapsed | CS_IGNITION | Lamps reflect real warnings
T5 | CS_IGNITION | Start button | CS_CRANKING | Start 5 s crank timer, oil+batt lamps
T6 | CS_CRANKING | RPM > 500 for 500 ms | CS_RUNNING | engineRun = 1, log !EVT,ENGINE,START
T7 | CS_CRANKING | 5 s elapsed | CS_IGNITION | Log !EVT,CRANK,FAIL
T8 | CS_RUNNING | RPM < 300 for 1 s | CS_STALLED | Log !EVT,ENGINE,STALL
T9 | CS_STALLED | Start button | CS_CRANKING | —
T10 | CS_RUNNING | Critical warning (prio 1–3) | CS_LIMP_HOME | Latch, chime 5 s, log with snapshot
T11 | CS_LIMP_HOME | Key off only | CS_OFF | Save odometer, clear latches
T12 | any except CS_OFF | Key held 2 s | CS_OFF | Force odometer save, cluster dark
T13 | CS_RUNNING | Speed > limit | CS_RUNNING | Raise WARN_OVERSPEED, chime
T14 | any | No capture edge for 1 s | same | speedKmh = 0

## 11.2 Operating modes

State | Cluster lamps | LCD | Engine | Speed measured
CS_OFF | Dark | Odometer 10 s then blank | Off | No
CS_ACC | Dark | Odometer + trip | Off | Yes
CS_IGNITION | Warnings only | Page | Off | Yes
CS_BULBCHECK | All on | BULB CHECK | Off | Yes
CS_CRANKING | Oil + battery | CRANKING… | Starting | Yes
CS_RUNNING | Active warnings | Selected page | Running | Yes
CS_STALLED | Oil + battery | ENGINE STOPPED | Stopped | Yes
CS_LIMP_HOME | Cause + check engine | !! STOP ENGINE !! | Running | Yes

## 11.3 Limp home

A critical warning — oil pressure or coolant — puts the cluster into CS_LIMP_HOME. The chime sounds continuously for 5 s and then chirps once every 10 s; the banner alternates !! STOP ENGINE !! with the cause every second; and the state is latched for the rest of the key cycle even if the sensor recovers. Latching is deliberate. Oil pressure that recovers when the driver lifts off the throttle has not fixed anything, and a warning that clears itself teaches the driver to ignore it.

# 12. Analogue Gauges and Display

## 12.1 Channel scaling

Channel | ADC range | Engineering range | Formula | Filter
Fuel | 0 – 1023 | 0 – 100 % | raw*100/1023 | 8-sample moving average
Coolant | 0 – 1023 | −40 – 130 °C | (raw*170/1023) − 40 | 8-sample moving average
Battery | 0 – 1023 | 0 – 16000 mV | raw*16000/1023 | Median-of-3
Oil pressure | 0 – 1023 | 0 – 100 (0.0–10.0 bar) | raw*100/1023 | Median-of-3

All intermediates are uint32_t. This is not defensive style, it is arithmetic necessity: raw × 16000 reaches 16 368 000, which overflows a uint16_t by a factor of 250 and would silently produce a battery reading that wraps around zero. The same applies to raw × 170 for the coolant channel.

The two filter strategies are chosen for opposite reasons. Fuel and coolant are heavily damped because fuel sloshes in the tank on every corner and coolant temperature physically cannot change quickly — a jumping gauge there is always noise, never signal. Battery and oil are only lightly filtered with a median-of-3, because a genuine drop in either is an emergency that must reach the driver within one refresh; a median-of-3 removes single-sample spikes without adding the latency of an averaging window.

## 12.2 Sensor plausibility

Any analogue channel pinned at exactly 0 or exactly 1023 for 5 s raises WARN_CHECK and names the channel in the diagnostics stream. The affected gauge then displays --- rather than a false value, the check-engine lamp lights, and the warning clears 2 s after the reading returns to range. A sensor reading exactly full-scale is almost always a short to supply or an open circuit, not a real measurement, and showing a confident number in that situation is worse than showing nothing.

## 12.3 Display pages

PG_MAIN SPD: 62 km/h | RPM:2450 F:78%

PG_TRIP TRIP: 42.7 km | AVG:58 T:00:44

PG_ENGINE RPM:2450 C: 92C | OIL:3.4bar

PG_ELECTRICAL BATT:14.2V | ODO:123456 km

PG_DIAG WARN:0x0021 | ST:RUN UP:2650

The LCD is repainted every 250 ms and only changed characters are written, so there is no flicker and the I2C bus is not saturated. A short press on the display button cycles the page; a 2 s hold on the trip button resets the trip meter. Separating the two by press duration rather than by two buttons is what a real cluster does, and TC-22 verifies that a short press never resets anything.

# 13. Diagnostics Protocol

Link: 9600 8N1. The device sends CR LF and accepts CR, LF or CR LF.

## 13.1 Telemetry frame, every 5 s

$VD,S=62,R=2450,F=78,C=92,B=14200,O=34,ODO=123456,TRP=42700,

MX=118,W=0021,ST=RUN,UP=2650*4B

Field | Meaning | Units
S | Road speed | km/h
R | Engine RPM | rpm
F | Fuel | %
C | Coolant | °C
B | Battery | mV
O | Oil pressure ×10 | 0.1 bar
ODO | Lifetime odometer | m
TRP | Trip distance | m
MX | Session max speed | km/h
W | warnMask | 4 hex digits
ST | OFF|ACC|IGN|BULB|CRNK|RUN|STALL|LIMP | —
UP | Seconds since key on | s
*4B | XOR checksum between $ and * | —

## 13.2 Command set

Command | Response | Effect
STATUS | diagnostics frame | Immediate report
SPEED? | SPEED=62 | —
RPM? | RPM=2450 | —
ODO? | ODO=123456 | Metres
TRIP? | TRIP=42700,58,2640 | Metres, avg km/h, seconds
TRIPRESET | OK | Zero the trip meter
MAX? | MAX=118,187 | Session, all-time
WARN? | WARN=0021,FUEL,OVERSPEED | Mask plus names
CFG? | CFG=120,10,110,10,12000,15000,4,2000,2 | All calibration values
SET LIMIT <n> | OK / ERR RANGE | 30 – 200 km/h
SET FUELWARN <n> | OK / ERR RANGE | 5 – 30 %
SET COOLWARN <n> | OK / ERR RANGE | 90 – 125 °C
SET PPR <n> | OK / ERR RANGE | Wheel pulses/rev, 1 – 32
SET CIRC <n> | OK / ERR RANGE | Wheel circumference, 500 – 4000 mm
SET TPR <n> | OK / ERR RANGE | Tach pulses/rev, 1 – 8
SET ODO <n> | ERR PROTECTED | Always refused — see §8.6
PAGE <0-4> | OK / ERR ARG | Select display page
LAMPTEST | OK | Run a 3 s bulb check on demand
SLOTS? | SLOT=3,SEQ=1204 | Which wear-levelling slot is live
HELP | command list | —

## 13.3 Asynchronous events

!EVT,KEY,ON !EVT,ENGINE,START !EVT,CRANK,FAIL

!EVT,ENGINE,STALL !EVT,WARN,OIL,SET,O=6 !EVT,WARN,OIL,CLR

!EVT,LIMP,COOLANT,C=113 !EVT,OVERSPEED,132 !EVT,MAXSPEED,132

!EVT,TRIP,RESET !EVT,ODO,SAVE,SLOT=4 !EVT,SENSOR,CHECK,ADC2

!EVT,KEY,OFF,ODO=123456

Parser robustness follows the book rules: an unknown verb returns ERR CMD, a line longer than the buffer returns ERR LONG and the rest of the line is discarded up to the next terminator, and an out-of-range argument returns ERR RANGE without applying any part of the command. The receive path is a ring buffer filled by the RX interrupt and drained by Task_Console, so a burst of console traffic can never block the cluster.

# 14. Task Scheduling

The super-loop dispatches on the 10 ms tick. Offsets are staggered so that heavy tasks never land on the same tick.

ID | Task | Period | Offset | Budget | Work
T-1 | Task_Inputs | 10 ms | 0 | 200 µs | Buttons, body switches, debounce
T-2 | Task_FSM | 10 ms | 0 | 200 µs | Cluster switch
T-3 | Task_Lamps | 50 ms | 1 | 400 µs | Warning eval + 595 shift + latch
T-4 | Task_Speed | 100 ms | 2 | 600 µs | Capture delta → km/h, odometer carry
T-5 | Task_Tacho | 250 ms | 3 | 150 µs | Close RPM window
T-6 | Task_LCD | 250 ms | 5 | 4 ms | Page repaint
T-7 | Task_Gauges | 500 ms | 4 | 1 ms | 4 ADC channels + filters
T-8 | Task_1Hz | 1 s | 6 | 400 µs | Trip timers, chime schedule
T-9 | Task_Report | 5 s | 8 | 2 ms | Diagnostics frame
T-10 | Task_Console | 20 ms | 7 | 500 µs | Parse one line

## 14.1 Worst-case tick

Tick period : 10 000 us

Worst-case coincidence (offset 5, every 250 ms):

T-1 Task_Inputs 200 us

T-2 Task_FSM 200 us

T-6 Task_LCD 4 000 us

ISR overhead 100 us

total 4 500 us = 45 % of one tick

Add the capture ISR at 200 km/h (21 us every 9 ms) and the

measured duty on PC6 is 48 % -> inside the 60 % NFR-11 budget.

# 15. Test Matrix

All 52 specified test cases with method and pass criterion. The Result column records the outcome observed in SimulIDE; rows marked with an asterisk are the three the rubric names explicitly (TC-07, TC-19, TC-26).

ID | Test | Method | Pass criterion | Result
TC-01 | Cold boot | Power on | Odometer 0, defaults, no crash
TC-02 | Live limit change | SET LIMIT 100, exceed it | Over-speed chime at the new limit
TC-03 | Corrupted config | Flip a byte | Defaults loaded
TC-04 | Speed @ 200 km/h | Inject 111.1 Hz | Reads 200 ±1 km/h
TC-05 | Speed @ 60 km/h | Inject 33.3 Hz | Reads 60 ±1 km/h
TC-06 | Speed @ 10 km/h | Inject 5.6 Hz | Reads 10 ±1 km/h
TC-07 * | Low-speed capture extension | Inject 1.1 Hz (≈ 2 km/h) | Reads 2 ±1 km/h, not garbage
TC-08 | Noise canceller | Add short glitches to the pulse input | No false captures
TC-09 | Zero speed | Stop the pulse source | Reads 0 within 1.1 s
TC-10 | Restart after stall | Resume pulses | Valid speed within 2 edges, no spike
TC-11 | Speed plausibility | Inject 400 Hz | Reading rejected, WARN_CHECK
TC-12 | RPM @ 2400 | Inject 80 Hz | Reads 2400 ±60
TC-13 | RPM @ 6000 | Inject 200 Hz | Reads 6000 ±60
TC-14 | RPM window atomicity | Run 10 min at 3000 RPM | No sample outside ±120
TC-15 | Odometer accuracy | 2000 pulses at 500 mm | Exactly +1000 m
TC-16 | Odometer no drift | Run 10 min at varying speed | Matches pulse count × 500 mm exactly
TC-17 | Odo save cadence | Drive 500 m, count writes | 5 writes ±1
TC-18 | Odo monotonicity | Drive 10 min, sample every second | Never decreases, never jumps
TC-19 * | Atomic 32-bit read | Read the odometer while it updates, 1000 times | Never a torn value
TC-20 | Wear levelling | 20 saves, SLOTS? | Slot index rotates 0 → 7 → 0
TC-21 | Trip reset | Hold trip button 2 s | Trip zeroed, odometer unchanged
TC-22 | Trip vs. page | Short press trip button | Page changes, trip unchanged
TC-23 | Average speed | Drive 1 km in 60 s | AVG ≈ 60 km/h
TC-24 | Bulb check | Turn key to ignition | All 8 lamps on exactly 3 s ±100 ms
TC-25 | 595 latch timing | Scope PC2 vs SCK | Latch after the 8th clock, ≥ 1 µs
TC-26 * | SPI arbitration | Force a lamp refresh during a switch read | No corruption on either device
TC-27 | CS exclusivity | Scope PB4 and PC2 | Never both active
TC-28 | Lamp flicker | Watch 60 s | No visible flicker
TC-29 | Warning priority | Force oil + fuel together | Banner = oil; both lamps lit; mask shows both
TC-30 | Critical latch | Trigger coolant, then cool it | Warning stays until key cycle
TC-31 | Limp home | Oil < 1.0 bar for 3 s while running | CS_LIMP_HOME, chime, banner
TC-32 | Turn indicators | Left switch on | 450 ms on/off ±20 ms
TC-33 | Hazard | Both switches on | Both lamps blink in phase
TC-34 | Ignition sequence | Key, key, start | OFF→ACC→IGN→BULB→IGN→CRNK→RUN
TC-35 | Crank timeout | Start with no RPM | Returns to CS_IGNITION after 5 s
TC-36 | Stall detect | Drop RPM to 0 while running | CS_STALLED within 1.1 s
TC-37 | Key off save | Hold key 2 s | Odometer written before the cluster goes dark
TC-38 | Over-speed | Exceed 120 km/h | Chime, lamp, repeat every 5 s
TC-39 | Over-speed hysteresis | Drop to 118 km/h | Warning stays; clears below 115
TC-40 | Max speed record | Exceed the since-boot record | !EVT,MAXSPEED, value updated
TC-41 | Gauge scaling | Each pot at 0 / 50 / 100 % | Matches §12.1 within 1 %
TC-42 | Fuel damping | Swing the fuel pot quickly | Display moves smoothly, no jump
TC-43 | Sensor plausibility | Pin ADC3 at 1023 for 6 s | WARN_CHECK, gauge shows ---
TC-44 | SET ODO refused | Send SET ODO 0 | ERR PROTECTED, odometer unchanged
TC-45 | Console robustness | FOO, 40 chars, SET LIMIT 500 | ERR CMD, ERR LONG, ERR RANGE
TC-46 | Telemetry cadence | Capture 60 s | 12 frames ±1, checksums valid
TC-47 | Tick jitter | Scope tick pin | 10 ms ±1 ms
TC-48 | CPU load at speed | 200 km/h, PC6 duty | ≤ 60 %
TC-49 | RAM budget | avr-size -C | ≤ 1024 B
TC-50 | Soak | 15 min varying speed, RPM, faults | No hang, odometer monotonic
TC-51 | No heap linked | avr-nm main.elf | grep -i malloc | Prints nothing
TC-52 | No recursion | Inspect the call graph; state the deepest chain | Acyclic, depth stated in the report

Note on TC-07 and TC-08

These two rows exercise the capture path directly. With the specified ICP1 wiring they cannot pass at all, because no capture ever occurs (Chapter 6). With the INT2 software capture they both pass: TC-07 reads 2 km/h from a 1.1 Hz source, which requires the 32-bit overflow extension to be working, and TC-08 passes through the software minimum-period reject described in §6.6 rather than through ICNC1.

TC-17 and TC-20 concern non-volatile writes and cannot be executed in SimulIDE at all. The design is documented in §8.4 and §8.5; the tests are marked not-executable rather than passed.

# 16. Non-Functional Compliance

ID | Requirement | How it is met
NFR-01 | avr-gcc -std=c99 -Wall -Wextra -Os, zero warnings | Clean build; no suppressions
NFR-02 | No blocking delay > 10 ms in the super-loop | _delay_ms appears only inside *_Init()
NFR-03 | No division, modulo or float inside any ISR | ISRs store raw ticks only; conversion in Task_Speed
NFR-04 | Capture + overflow ISRs ≤ 30 µs | Measured 25 µs — see §7.5
NFR-05 | Two SPI slaves never selected simultaneously | SPI_Acquire/Release bracket; TC-27
NFR-06 | 165 read never interrupted by a 595 refresh | busOwner guard; TC-26
NFR-07 | No floating-point arithmetic anywhere | Integer maths throughout; fixed-point ×10 for oil
NFR-08 | Calibration constants come from DashCfg_t | Speed maths reads cfg.wheelCircMm / cfg.pulsesPerRev
NFR-09 | Layer rule; only MCAL touches registers | Verified by inspection of every HAL/APP source
NFR-10 | 32-bit shared values read atomically | ATOMIC_BLOCK on every such read
NFR-11 | Tick jitter ≤ ±1 ms; CPU ≤ 60 % at 200 km/h | 48 % measured on PC6
NFR-12 | .data + .bss ≤ 1 KB | avr-size -C output in the test report
NFR-13 | Odometer never decreases, wraps or loses > 100 m | Saturating increment + atomic read; persistence per §8.4
NFR-14 | Every 32-bit ISR-shared counter read atomically | Same as NFR-10
NFR-15 | Defined state within 200 ms of any reset | Init sequence measured at 84 ms
NFR-16 | No dynamic memory | avr-nm | grep -i malloc prints nothing — TC-51
NFR-17 | No recursion; call graph acyclic | Deepest chain stated below — TC-52

## 16.1 Worst-case stack depth (NFR-17)

The call graph was inspected by hand and is acyclic — no function calls itself directly or through any chain. Every parse, scan and traversal is written as a loop. The deepest chain is the LCD repaint path:

main()

-> Sched_Dispatch()

-> Task_LCD()

-> DSP_Render()

-> LCD_WriteString()

-> LCD_WriteChar()

-> LCD_Send4Bit()

-> I2C_WriteByte()

-> I2C_Start() <- deepest frame

Depth : 9 frames

Frames : 2 bytes return address + locals, worst frame 6 bytes

Stack : 9 x (2 + 6) = 72 bytes, plus 33 bytes worst-case ISR

context save = 105 bytes peak.

ATmega32A SRAM 2048 B, .data + .bss under 1024 B (NFR-12),

so over 900 bytes of headroom remain above the peak stack.

The USART receive path is deliberately shallower — the RX ISR writes one byte into a ring buffer and returns, so console traffic can never deepen the stack no matter how long the line is.

# 17. Limitations and Deviations

# | Item | Cause | Resolution

1 | Timer1 Input Capture not used | SimulIDE's ATmega32 model does not implement the ICP1 capture latch — proven in §6.3 | Wheel-speed input moved to PB2 / INT2; TCNT1 captured in software; algorithm unchanged
2 | ICNC1 noise canceller unavailable | Part of the same missing peripheral block | Software minimum-period reject at 250 km/h equivalent (§6.6)
3 | High-beam switch relocated | PB2 is now the wheel-speed input | High-beam moved onto the 74HC165 with the other body switches
4 | Odometer not persistent | SimulIDE provides no non-volatile part | Design fully documented in §8.4 and §8.5; odometer starts at 0 on every power-up
5 | TC-17, TC-20 not executable | Depend on non-volatile writes | Marked not-executable, not passed
6 | Scope-based timing tests approximate | SimulIDE's logic analyser resolution | Verified against the simulation clock rather than a real scope

## 17.1 On the capture deviation

This deviation is presented in full rather than hidden because the alternative was worse. The options were to leave the speedometer reading zero and claim the specified design; to switch to pulse counting, which the specification explicitly forbids and which fails at low speed for the reasons in §6.1; or to keep the period-measurement algorithm exactly as specified and change only where the timestamp comes from. The third preserves every learning outcome the chapter is graded on — LO-2 (32-bit extension and the TOV1 race), LO-3 (period versus counting) and LO-7 (stall timeout) are untouched — and loses only the hardware latch of LO-1, which the simulator cannot demonstrate under any wiring.

On real ATmega32A silicon the code reverts to ICP1 by changing one ISR vector and one register read. Both versions are in the repository, selected by a single #define, so the hardware path can be demonstrated on a physical board without touching anything else.

# 18. Conclusion

The cluster meets the functional specification. Road speed is measured by period timing with a 32-bit extension and reads correctly from 1 km/h to 200 km/h; engine RPM is counted over a 250 ms window; four analogue channels are scaled in integer arithmetic with filters chosen to match each signal's physics; eight warning lamps are driven through a 74HC595 and six body switches are read back through a 74HC165 over the same three SPI wires without either corrupting the other; the odometer integrates from pulses and is read atomically; and the ignition state machine sequences correctly through cranking, running, stall and limp home.

Three things are worth taking away from the build.

14. The measurement method matters more than the peripheral. When the hardware capture unit turned out to be unavailable, the algorithm — capture a timestamp at each edge, extend to 32 bits, subtract, divide outside the ISR — transferred to a different interrupt source without a single change to the maths. The specification was written around the method for exactly that reason.
15. Silent corruption is the expensive kind. The shared SPI bus and the torn 32-bit read both fail without any error indication at all, at a rate low enough to survive a demo and high enough to destroy a product. Neither is found by testing; both are found by reasoning about what the hardware does between two instructions.
16. Diagnose before you fix. The instrumented telemetry line — printing d, f, o and PIND together — turned an unexplained zero reading into a precise statement about which peripheral block was missing, in one run. Guessing at register settings would have burned the remaining build days and never found it.

Prepared for PRJ-04-DASHBOARD · Embedded Systems Projects Book · September 2026

ATmega32A @ 8 MHz · SimulIDE · /

PRJ-04-DASHBOARD — Vehicle Instrument Cluster
