omarheshamm0/vechile-dashboard-NTI/vehicle_dashboard(Drivers&codes)/buildlog.txt

if exist "build" rmdir /S /Q "build"
Cleaned build
if not exist "build/" mkdir "build/"
avr-gcc -mmcu=atmega32 -DF_CPU=8000000UL -Os -Wall -std=gnu99 -ffunction-sections -fdata-sections -I. -I./ -IHAL -IHAL/KeyPad/ -IHAL/SevenSegment/ -ILIB -ILIB/ -ILogic -IMCAL -IMCAL/ADC/ -IMCAL/GPIO/ -IMCAL/I2C/ -IMCAL/INTERRUPT/ -IMCAL/SPI/ -IMCAL/TIMER/ -IMCAL/UART/ -E main.c -o build/main.i
if not exist "build/HAL/KeyPad/" mkdir "build/HAL/KeyPad/"
avr-gcc -mmcu=atmega32 -DF_CPU=8000000UL -Os -Wall -std=gnu99 -ffunction-sections -fdata-sections -I. -I./ -IHAL -IHAL/KeyPad/ -IHAL/SevenSegment/ -ILIB -ILIB/ -ILogic -IMCAL -IMCAL/ADC/ -IMCAL/GPIO/ -IMCAL/I2C/ -IMCAL/INTERRUPT/ -IMCAL/SPI/ -IMCAL/TIMER/ -IMCAL/UART/ -E HAL/KeyPad/KeyPad.c -o build/HAL/KeyPad/KeyPad.i
if not exist "build/HAL/SevenSegment/" mkdir "build/HAL/SevenSegment/"
avr-gcc -mmcu=atmega32 -DF_CPU=8000000UL -Os -Wall -std=gnu99 -ffunction-sections -fdata-sections -I. -I./ -IHAL -IHAL/KeyPad/ -IHAL/SevenSegment/ -ILIB -ILIB/ -ILogic -IMCAL -IMCAL/ADC/ -IMCAL/GPIO/ -IMCAL/I2C/ -IMCAL/INTERRUPT/ -IMCAL/SPI/ -IMCAL/TIMER/ -IMCAL/UART/ -E HAL/SevenSegment/SevenSegment.c -o build/HAL/SevenSegment/SevenSegment.i
if not exist "build/MCAL/ADC/" mkdir "build/MCAL/ADC/"
avr-gcc -mmcu=atmega32 -DF_CPU=8000000UL -Os -Wall -std=gnu99 -ffunction-sections -fdata-sections -I. -I./ -IHAL -IHAL/KeyPad/ -IHAL/SevenSegment/ -ILIB -ILIB/ -ILogic -IMCAL -IMCAL/ADC/ -IMCAL/GPIO/ -IMCAL/I2C/ -IMCAL/INTERRUPT/ -IMCAL/SPI/ -IMCAL/TIMER/ -IMCAL/UART/ -E MCAL/ADC/ADC.c -o build/MCAL/ADC/ADC.i
if not exist "build/MCAL/GPIO/" mkdir "build/MCAL/GPIO/"
avr-gcc -mmcu=atmega32 -DF_CPU=8000000UL -Os -Wall -std=gnu99 -ffunction-sections -fdata-sections -I. -I./ -IHAL -IHAL/KeyPad/ -IHAL/SevenSegment/ -ILIB -ILIB/ -ILogic -IMCAL -IMCAL/ADC/ -IMCAL/GPIO/ -IMCAL/I2C/ -IMCAL/INTERRUPT/ -IMCAL/SPI/ -IMCAL/TIMER/ -IMCAL/UART/ -E MCAL/GPIO/GPIO.c -o build/MCAL/GPIO/GPIO.i
if not exist "build/MCAL/I2C/" mkdir "build/MCAL/I2C/"
avr-gcc -mmcu=atmega32 -DF_CPU=8000000UL -Os -Wall -std=gnu99 -ffunction-sections -fdata-sections -I. -I./ -IHAL -IHAL/KeyPad/ -IHAL/SevenSegment/ -ILIB -ILIB/ -ILogic -IMCAL -IMCAL/ADC/ -IMCAL/GPIO/ -IMCAL/I2C/ -IMCAL/INTERRUPT/ -IMCAL/SPI/ -IMCAL/TIMER/ -IMCAL/UART/ -E MCAL/I2C/I2C.c -o build/MCAL/I2C/I2C.i
if not exist "build/MCAL/INTERRUPT/" mkdir "build/MCAL/INTERRUPT/"
avr-gcc -mmcu=atmega32 -DF_CPU=8000000UL -Os -Wall -std=gnu99 -ffunction-sections -fdata-sections -I. -I./ -IHAL -IHAL/KeyPad/ -IHAL/SevenSegment/ -ILIB -ILIB/ -ILogic -IMCAL -IMCAL/ADC/ -IMCAL/GPIO/ -IMCAL/I2C/ -IMCAL/INTERRUPT/ -IMCAL/SPI/ -IMCAL/TIMER/ -IMCAL/UART/ -E MCAL/INTERRUPT/INTERRUPT.c -o build/MCAL/INTERRUPT/INTERRUPT.i
if not exist "build/MCAL/SPI/" mkdir "build/MCAL/SPI/"
avr-gcc -mmcu=atmega32 -DF_CPU=8000000UL -Os -Wall -std=gnu99 -ffunction-sections -fdata-sections -I. -I./ -IHAL -IHAL/KeyPad/ -IHAL/SevenSegment/ -ILIB -ILIB/ -ILogic -IMCAL -IMCAL/ADC/ -IMCAL/GPIO/ -IMCAL/I2C/ -IMCAL/INTERRUPT/ -IMCAL/SPI/ -IMCAL/TIMER/ -IMCAL/UART/ -E MCAL/SPI/SPI.c -o build/MCAL/SPI/SPI.i
if not exist "build/MCAL/TIMER/" mkdir "build/MCAL/TIMER/"
avr-gcc -mmcu=atmega32 -DF_CPU=8000000UL -Os -Wall -std=gnu99 -ffunction-sections -fdata-sections -I. -I./ -IHAL -IHAL/KeyPad/ -IHAL/SevenSegment/ -ILIB -ILIB/ -ILogic -IMCAL -IMCAL/ADC/ -IMCAL/GPIO/ -IMCAL/I2C/ -IMCAL/INTERRUPT/ -IMCAL/SPI/ -IMCAL/TIMER/ -IMCAL/UART/ -E MCAL/TIMER/TIMER.c -o build/MCAL/TIMER/TIMER.i
if not exist "build/MCAL/UART/" mkdir "build/MCAL/UART/"
avr-gcc -mmcu=atmega32 -DF_CPU=8000000UL -Os -Wall -std=gnu99 -ffunction-sections -fdata-sections -I. -I./ -IHAL -IHAL/KeyPad/ -IHAL/SevenSegment/ -ILIB -ILIB/ -ILogic -IMCAL -IMCAL/ADC/ -IMCAL/GPIO/ -IMCAL/I2C/ -IMCAL/INTERRUPT/ -IMCAL/SPI/ -IMCAL/TIMER/ -IMCAL/UART/ -E MCAL/UART/UART.c -o build/MCAL/UART/UART.i
if not exist "build/" mkdir "build/"
avr-gcc -mmcu=atmega32 -DF_CPU=8000000UL -Os -Wall -std=gnu99 -ffunction-sections -fdata-sections -I. -I./ -IHAL -IHAL/KeyPad/ -IHAL/SevenSegment/ -ILIB -ILIB/ -ILogic -IMCAL -IMCAL/ADC/ -IMCAL/GPIO/ -IMCAL/I2C/ -IMCAL/INTERRUPT/ -IMCAL/SPI/ -IMCAL/TIMER/ -IMCAL/UART/ -S main.c -o build/main.s
if not exist "build/HAL/KeyPad/" mkdir "build/HAL/KeyPad/"
avr-gcc -mmcu=atmega32 -DF_CPU=8000000UL -Os -Wall -std=gnu99 -ffunction-sections -fdata-sections -I. -I./ -IHAL -IHAL/KeyPad/ -IHAL/SevenSegment/ -ILIB -ILIB/ -ILogic -IMCAL -IMCAL/ADC/ -IMCAL/GPIO/ -IMCAL/I2C/ -IMCAL/INTERRUPT/ -IMCAL/SPI/ -IMCAL/TIMER/ -IMCAL/UART/ -S HAL/KeyPad/KeyPad.c -o build/HAL/KeyPad/KeyPad.s
if not exist "build/HAL/SevenSegment/" mkdir "build/HAL/SevenSegment/"
avr-gcc -mmcu=atmega32 -DF_CPU=8000000UL -Os -Wall -std=gnu99 -ffunction-sections -fdata-sections -I. -I./ -IHAL -IHAL/KeyPad/ -IHAL/SevenSegment/ -ILIB -ILIB/ -ILogic -IMCAL -IMCAL/ADC/ -IMCAL/GPIO/ -IMCAL/I2C/ -IMCAL/INTERRUPT/ -IMCAL/SPI/ -IMCAL/TIMER/ -IMCAL/UART/ -S HAL/SevenSegment/SevenSegment.c -o build/HAL/SevenSegment/SevenSegment.s
if not exist "build/MCAL/ADC/" mkdir "build/MCAL/ADC/"
avr-gcc -mmcu=atmega32 -DF_CPU=8000000UL -Os -Wall -std=gnu99 -ffunction-sections -fdata-sections -I. -I./ -IHAL -IHAL/KeyPad/ -IHAL/SevenSegment/ -ILIB -ILIB/ -ILogic -IMCAL -IMCAL/ADC/ -IMCAL/GPIO/ -IMCAL/I2C/ -IMCAL/INTERRUPT/ -IMCAL/SPI/ -IMCAL/TIMER/ -IMCAL/UART/ -S MCAL/ADC/ADC.c -o build/MCAL/ADC/ADC.s
if not exist "build/MCAL/GPIO/" mkdir "build/MCAL/GPIO/"
avr-gcc -mmcu=atmega32 -DF_CPU=8000000UL -Os -Wall -std=gnu99 -ffunction-sections -fdata-sections -I. -I./ -IHAL -IHAL/KeyPad/ -IHAL/SevenSegment/ -ILIB -ILIB/ -ILogic -IMCAL -IMCAL/ADC/ -IMCAL/GPIO/ -IMCAL/I2C/ -IMCAL/INTERRUPT/ -IMCAL/SPI/ -IMCAL/TIMER/ -IMCAL/UART/ -S MCAL/GPIO/GPIO.c -o build/MCAL/GPIO/GPIO.s
if not exist "build/MCAL/I2C/" mkdir "build/MCAL/I2C/"
avr-gcc -mmcu=atmega32 -DF_CPU=8000000UL -Os -Wall -std=gnu99 -ffunction-sections -fdata-sections -I. -I./ -IHAL -IHAL/KeyPad/ -IHAL/SevenSegment/ -ILIB -ILIB/ -ILogic -IMCAL -IMCAL/ADC/ -IMCAL/GPIO/ -IMCAL/I2C/ -IMCAL/INTERRUPT/ -IMCAL/SPI/ -IMCAL/TIMER/ -IMCAL/UART/ -S MCAL/I2C/I2C.c -o build/MCAL/I2C/I2C.s
if not exist "build/MCAL/INTERRUPT/" mkdir "build/MCAL/INTERRUPT/"
avr-gcc -mmcu=atmega32 -DF_CPU=8000000UL -Os -Wall -std=gnu99 -ffunction-sections -fdata-sections -I. -I./ -IHAL -IHAL/KeyPad/ -IHAL/SevenSegment/ -ILIB -ILIB/ -ILogic -IMCAL -IMCAL/ADC/ -IMCAL/GPIO/ -IMCAL/I2C/ -IMCAL/INTERRUPT/ -IMCAL/SPI/ -IMCAL/TIMER/ -IMCAL/UART/ -S MCAL/INTERRUPT/INTERRUPT.c -o build/MCAL/INTERRUPT/INTERRUPT.s
if not exist "build/MCAL/SPI/" mkdir "build/MCAL/SPI/"
avr-gcc -mmcu=atmega32 -DF_CPU=8000000UL -Os -Wall -std=gnu99 -ffunction-sections -fdata-sections -I. -I./ -IHAL -IHAL/KeyPad/ -IHAL/SevenSegment/ -ILIB -ILIB/ -ILogic -IMCAL -IMCAL/ADC/ -IMCAL/GPIO/ -IMCAL/I2C/ -IMCAL/INTERRUPT/ -IMCAL/SPI/ -IMCAL/TIMER/ -IMCAL/UART/ -S MCAL/SPI/SPI.c -o build/MCAL/SPI/SPI.s
if not exist "build/MCAL/TIMER/" mkdir "build/MCAL/TIMER/"
avr-gcc -mmcu=atmega32 -DF_CPU=8000000UL -Os -Wall -std=gnu99 -ffunction-sections -fdata-sections -I. -I./ -IHAL -IHAL/KeyPad/ -IHAL/SevenSegment/ -ILIB -ILIB/ -ILogic -IMCAL -IMCAL/ADC/ -IMCAL/GPIO/ -IMCAL/I2C/ -IMCAL/INTERRUPT/ -IMCAL/SPI/ -IMCAL/TIMER/ -IMCAL/UART/ -S MCAL/TIMER/TIMER.c -o build/MCAL/TIMER/TIMER.s
if not exist "build/MCAL/UART/" mkdir "build/MCAL/UART/"
avr-gcc -mmcu=atmega32 -DF_CPU=8000000UL -Os -Wall -std=gnu99 -ffunction-sections -fdata-sections -I. -I./ -IHAL -IHAL/KeyPad/ -IHAL/SevenSegment/ -ILIB -ILIB/ -ILogic -IMCAL -IMCAL/ADC/ -IMCAL/GPIO/ -IMCAL/I2C/ -IMCAL/INTERRUPT/ -IMCAL/SPI/ -IMCAL/TIMER/ -IMCAL/UART/ -S MCAL/UART/UART.c -o build/MCAL/UART/UART.s
if not exist "build/" mkdir "build/"
avr-gcc -mmcu=atmega32 -DF_CPU=8000000UL -Os -Wall -std=gnu99 -ffunction-sections -fdata-sections -I. -I./ -IHAL -IHAL/KeyPad/ -IHAL/SevenSegment/ -ILIB -ILIB/ -ILogic -IMCAL -IMCAL/ADC/ -IMCAL/GPIO/ -IMCAL/I2C/ -IMCAL/INTERRUPT/ -IMCAL/SPI/ -IMCAL/TIMER/ -IMCAL/UART/ -c main.c -o build/main.o
if not exist "build/HAL/KeyPad/" mkdir "build/HAL/KeyPad/"
avr-gcc -mmcu=atmega32 -DF_CPU=8000000UL -Os -Wall -std=gnu99 -ffunction-sections -fdata-sections -I. -I./ -IHAL -IHAL/KeyPad/ -IHAL/SevenSegment/ -ILIB -ILIB/ -ILogic -IMCAL -IMCAL/ADC/ -IMCAL/GPIO/ -IMCAL/I2C/ -IMCAL/INTERRUPT/ -IMCAL/SPI/ -IMCAL/TIMER/ -IMCAL/UART/ -c HAL/KeyPad/KeyPad.c -o build/HAL/KeyPad/KeyPad.o
if not exist "build/HAL/SevenSegment/" mkdir "build/HAL/SevenSegment/"
avr-gcc -mmcu=atmega32 -DF_CPU=8000000UL -Os -Wall -std=gnu99 -ffunction-sections -fdata-sections -I. -I./ -IHAL -IHAL/KeyPad/ -IHAL/SevenSegment/ -ILIB -ILIB/ -ILogic -IMCAL -IMCAL/ADC/ -IMCAL/GPIO/ -IMCAL/I2C/ -IMCAL/INTERRUPT/ -IMCAL/SPI/ -IMCAL/TIMER/ -IMCAL/UART/ -c HAL/SevenSegment/SevenSegment.c -o build/HAL/SevenSegment/SevenSegment.o
if not exist "build/MCAL/ADC/" mkdir "build/MCAL/ADC/"
avr-gcc -mmcu=atmega32 -DF_CPU=8000000UL -Os -Wall -std=gnu99 -ffunction-sections -fdata-sections -I. -I./ -IHAL -IHAL/KeyPad/ -IHAL/SevenSegment/ -ILIB -ILIB/ -ILogic -IMCAL -IMCAL/ADC/ -IMCAL/GPIO/ -IMCAL/I2C/ -IMCAL/INTERRUPT/ -IMCAL/SPI/ -IMCAL/TIMER/ -IMCAL/UART/ -c MCAL/ADC/ADC.c -o build/MCAL/ADC/ADC.o
if not exist "build/MCAL/GPIO/" mkdir "build/MCAL/GPIO/"
avr-gcc -mmcu=atmega32 -DF_CPU=8000000UL -Os -Wall -std=gnu99 -ffunction-sections -fdata-sections -I. -I./ -IHAL -IHAL/KeyPad/ -IHAL/SevenSegment/ -ILIB -ILIB/ -ILogic -IMCAL -IMCAL/ADC/ -IMCAL/GPIO/ -IMCAL/I2C/ -IMCAL/INTERRUPT/ -IMCAL/SPI/ -IMCAL/TIMER/ -IMCAL/UART/ -c MCAL/GPIO/GPIO.c -o build/MCAL/GPIO/GPIO.o
if not exist "build/MCAL/I2C/" mkdir "build/MCAL/I2C/"
avr-gcc -mmcu=atmega32 -DF_CPU=8000000UL -Os -Wall -std=gnu99 -ffunction-sections -fdata-sections -I. -I./ -IHAL -IHAL/KeyPad/ -IHAL/SevenSegment/ -ILIB -ILIB/ -ILogic -IMCAL -IMCAL/ADC/ -IMCAL/GPIO/ -IMCAL/I2C/ -IMCAL/INTERRUPT/ -IMCAL/SPI/ -IMCAL/TIMER/ -IMCAL/UART/ -c MCAL/I2C/I2C.c -o build/MCAL/I2C/I2C.o
if not exist "build/MCAL/INTERRUPT/" mkdir "build/MCAL/INTERRUPT/"
avr-gcc -mmcu=atmega32 -DF_CPU=8000000UL -Os -Wall -std=gnu99 -ffunction-sections -fdata-sections -I. -I./ -IHAL -IHAL/KeyPad/ -IHAL/SevenSegment/ -ILIB -ILIB/ -ILogic -IMCAL -IMCAL/ADC/ -IMCAL/GPIO/ -IMCAL/I2C/ -IMCAL/INTERRUPT/ -IMCAL/SPI/ -IMCAL/TIMER/ -IMCAL/UART/ -c MCAL/INTERRUPT/INTERRUPT.c -o build/MCAL/INTERRUPT/INTERRUPT.o
if not exist "build/MCAL/SPI/" mkdir "build/MCAL/SPI/"
avr-gcc -mmcu=atmega32 -DF_CPU=8000000UL -Os -Wall -std=gnu99 -ffunction-sections -fdata-sections -I. -I./ -IHAL -IHAL/KeyPad/ -IHAL/SevenSegment/ -ILIB -ILIB/ -ILogic -IMCAL -IMCAL/ADC/ -IMCAL/GPIO/ -IMCAL/I2C/ -IMCAL/INTERRUPT/ -IMCAL/SPI/ -IMCAL/TIMER/ -IMCAL/UART/ -c MCAL/SPI/SPI.c -o build/MCAL/SPI/SPI.o
if not exist "build/MCAL/TIMER/" mkdir "build/MCAL/TIMER/"
avr-gcc -mmcu=atmega32 -DF_CPU=8000000UL -Os -Wall -std=gnu99 -ffunction-sections -fdata-sections -I. -I./ -IHAL -IHAL/KeyPad/ -IHAL/SevenSegment/ -ILIB -ILIB/ -ILogic -IMCAL -IMCAL/ADC/ -IMCAL/GPIO/ -IMCAL/I2C/ -IMCAL/INTERRUPT/ -IMCAL/SPI/ -IMCAL/TIMER/ -IMCAL/UART/ -c MCAL/TIMER/TIMER.c -o build/MCAL/TIMER/TIMER.o
if not exist "build/MCAL/UART/" mkdir "build/MCAL/UART/"
avr-gcc -mmcu=atmega32 -DF_CPU=8000000UL -Os -Wall -std=gnu99 -ffunction-sections -fdata-sections -I. -I./ -IHAL -IHAL/KeyPad/ -IHAL/SevenSegment/ -ILIB -ILIB/ -ILogic -IMCAL -IMCAL/ADC/ -IMCAL/GPIO/ -IMCAL/I2C/ -IMCAL/INTERRUPT/ -IMCAL/SPI/ -IMCAL/TIMER/ -IMCAL/UART/ -c MCAL/UART/UART.c -o build/MCAL/UART/UART.o
if not exist "build" mkdir "build"
avr-gcc -mmcu=atmega32 -Wl,--gc-sections -Wl,-Map=build/program.map build/main.o build/HAL/KeyPad/KeyPad.o build/HAL/SevenSegment/SevenSegment.o build/MCAL/ADC/ADC.o build/MCAL/GPIO/GPIO.o build/MCAL/I2C/I2C.o build/MCAL/INTERRUPT/INTERRUPT.o build/MCAL/SPI/SPI.o build/MCAL/TIMER/TIMER.o build/MCAL/UART/UART.o -o build/program.elf
avr-objcopy -O ihex -R .eeprom build/program.elf build/program.hex
HEX ready: build/program.hex
avr-objcopy -O binary -R .eeprom build/program.elf build/program.bin
BIN ready: build/program.bin
avr-size build/program.elf
   text	   data	    bss	    dec	    hex	filename
    926	      0	      0	    926	    39e	build/program.elf
