omarheshamm0/vechile-dashboard-NTI/(list of files, drawings)

Other design files:
vehicle.sim1
