omarheshamm0/vechile-dashboard-NTI/vehicle_dashboard(Drivers&codes)/MCAL/UART/UART_private.h

#ifndef UART_PRIVATE_H
#define UART_PRIVATE_H

/*
 * Author: Ahmed Ellamie
 * Email:  ahmed.ellamiee@gmail.com
 *
 * STUDENT TASK — UART private layer (ATmega32 USART)
 * Include this file ONLY from UART.c.
 *
 * What you must add here:
 * 1. Registers:
 *      UDR    0x2C    shared TX / RX data
 *      UCSRA  0x2B    RXC TXC UDRE FE DOR PE U2X MPCM
 *      UCSRB  0x2A    RXCIE TXCIE UDRIE RXEN TXEN UCSZ2 RXB8 TXB8
 *      UCSRC  0x40    URSEL UMSEL UPM1 UPM0 USBS UCSZ1 UCSZ0 UCPOL
 *      UBRRL  0x29
 *      UBRRH  0x40    same address as UCSRC — URSEL selects which one
 *
 * 2. Bit names you will poll:
 *      UDRE = 5 in UCSRA  (transmitter ready)
 *      RXC  = 7 in UCSRA  (byte received)
 *      RXEN = 4, TXEN = 3 in UCSRB
 *
 * 3. 8N1 in UCSRC (must set URSEL = 1 when writing UCSRC):
 *      URSEL=1, UMSEL=0 (async), UPM=00 (no parity), USBS=0 (1 stop),
 *      UCSZ1:0 = 11 (8-bit). UCSZ2 in UCSRB stays 0.
 *
 * 4. Baud helper:
 *      ubrr = (F_CPU / (16UL * baud)) - 1     // U2X = 0
 *      write UBRRH (URSEL=0) then UBRRL.
 *
 * 5. This project uses F_CPU 8000000UL unless you override it.
 */

#define UART_UDR   (*(volatile uint8 *)0x2C)
#define UART_UCSRA (*(volatile uint8 *)0x2B)
#define UART_UCSRB (*(volatile uint8 *)0x2A)
#define UART_UCSRC (*(volatile uint8 *)0x40)
#define UART_UBRRL (*(volatile uint8 *)0x29)
#define UART_UBRRH (*(volatile uint8 *)0x40)

#define UART_UDRE  5u
#define UART_RXC   7u
#define UART_RXEN  4u
#define UART_TXEN  3u
#define UART_RXCIE 7u
#define UART_UDRIE 5u
#define UART_URSEL 7u
#define UART_UCSZ1 2u
#define UART_UCSZ0 1u

#endif /* UART_PRIVATE_H */
