omarheshamm0/vechile-dashboard-NTI/(commit log)

2026-09-13 add drivers codes
2026-09-14 add HAL drivers and dashboard_types.h
2026-09-14 implement in MCAL : UART and SPI drivers
2026-09-14 implement lamps595 HAL driver
2026-09-14 Refactor ADC and TIMER drivers for improved readability and consistency
    - Updated bitwise operations in ADC and TIMER drivers to use explicit type casting for clarity.
    - Added necessary includes for standard types in ADC and TIMER files.
    - Enhanced code formatting for better readability.
    - Updated binary, ELF, HEX, and MAP files to reflect the latest changes in the codebase.
2026-09-14 implement bodysw "74HC165" driver in HAL
2026-09-15 Implement I2C driver
2026-09-15 Define F_CPU in I2C.c to ensure proper clock frequency configuration
2026-09-15 add APP layer inside Driver_codes folder to be seen in build
2026-09-15 implement lcd_i2c driver
2026-09-15 fix in i2c and lcd
    [lcd_i2c.c, lcd_i2c.h]
2026-09-15 test LCD and i2c successfully
2026-09-16 enhance in UART, use of interrupts in interruptbased funcrions
2026-09-16 fix: correct GPIO pin direction definition for PORTC
    [main.c]
2026-09-16 gauges fixed and tested
    [gauges.c, main.c]
2026-09-16 Refactor SPEEDO and TACHO modules for improved functionality and performance
    - Updated SPEEDO module:
    - Modified SPD_Init function to adjust initialization parameters.
    - Removed unnecessary interrupt service routines (ISRs) and optimized SPD_Task100ms function.
    - Enhanced data handling and removed unused global variables.
    - Refactored TACHO module:
    - Replaced global pulse count variable with a static variable for better encapsulation.
    - Simplified TAC_Init and TAC_Task250ms functions to improve readability and efficiency.
    - Updated interrupt handling to use inline assembly for better performance.
    - Removed redundant code and improved overall structure of the module.
    These cha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
2026-09-17 gpio fix in main
    [main.c]
2026-09-17 Add files via upload
    hardware
    [vehicle.sim1]
2026-09-17 Add files via upload
    fnal hardware design
    [vehicle.sim1]
